Bhavesh6/PPE-Detection/frontend/assets/checkpoint-granted.png

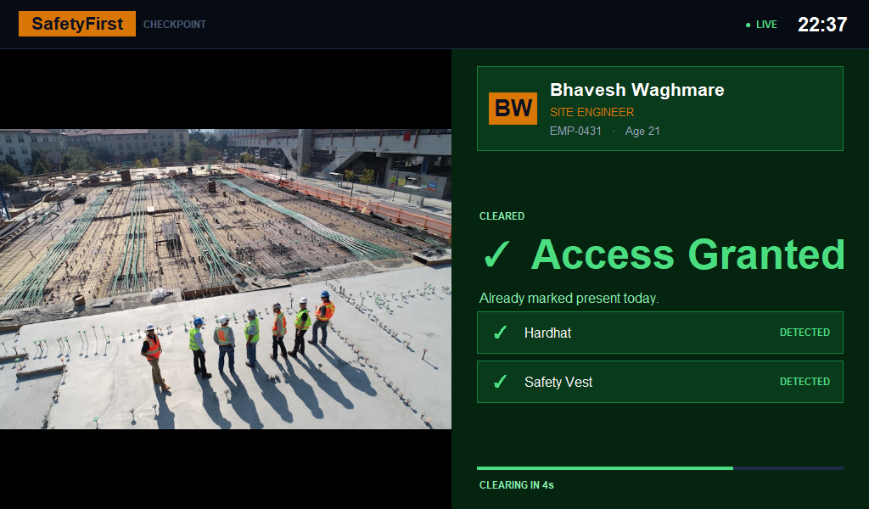
frontend/assets/checkpoint-granted.png
