Bhavesh6/PPE-Detection/frontend/assets/checkpoint-denied.png

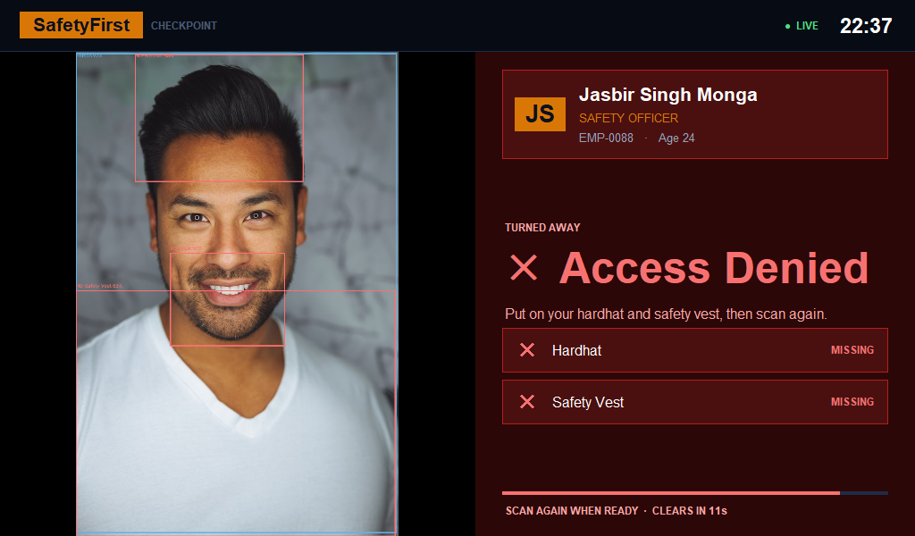
frontend/assets/checkpoint-denied.png
