Bhavesh6/PPE-Detection/frontend/assets/checkpoint-idle.png

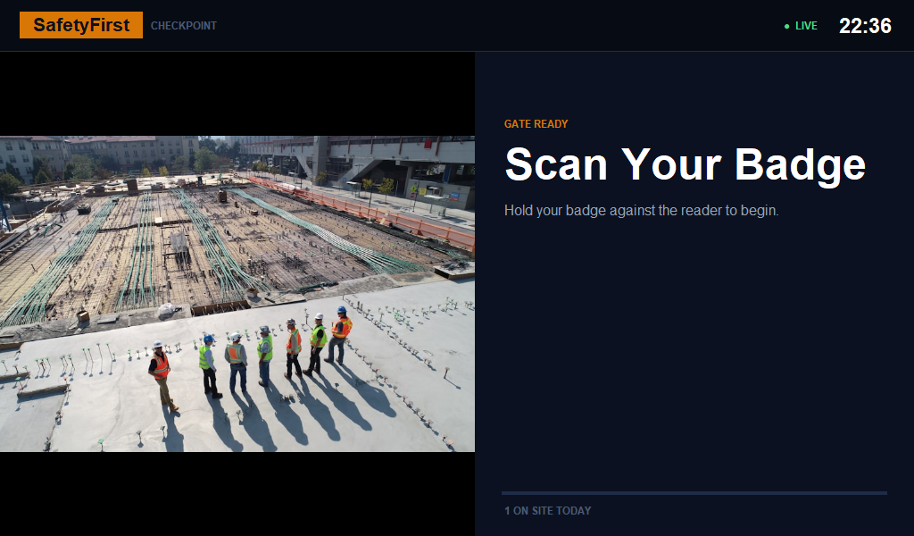
frontend/assets/checkpoint-idle.png
