Bhavesh6/PPE-Detection/pi_app/doctor.py

"""Pre-flight check for the checkpoint device.

Run this on the Pi before trusting the gate - it walks the chain from
kernel to badge to backend and says which link is broken, rather than
leaving you to infer it from a blank screen at demo time.

    python doctor.py            # everything except the card read
    python doctor.py --scan     # also waits for a badge to be presented
"""

from __future__ import annotations

import glob
import os
import sys
from pathlib import Path

# Read the same .env checkpoint.py reads, before anything below looks at
# os.environ. Without this the doctor diagnoses a configuration nobody
# runs: it would miss SAFETYFIRST_GPS=off and pass a GPS the gate has
# switched off, check localhost instead of the real SAFETYFIRST_API, and
# warn about missing device credentials that are sitting in the file. A
# pre-flight check that reads different settings than the app is worse
# than none, because it is believed.
try:
    from dotenv import load_dotenv

    load_dotenv(Path(__file__).with_name(".env"))
except ImportError:
    pass

OK, BAD, WARN = "  OK  ", " FAIL ", " WARN "
_failures = 0
_warnings = 0


def report(status, title, detail=""):
    global _failures, _warnings
    if status is BAD:
        _failures += 1
    elif status is WARN:
        _warnings += 1
    print(f"[{status}] {title}")
    if detail:
        for line in str(detail).splitlines():
            print(f"         {line}")


def check_platform():
    model = "unknown"
    try:
        with open("/proc/device-tree/model") as f:
            model = f.read().strip("\x00").strip()
    except OSError:
        pass

    if "Raspberry Pi" in model:
        report(OK, "Hardware", model)
    else:
        report(WARN, "Hardware", f"Not a Raspberry Pi ({model}).\n"
                                 "SPI and GPIO checks below will fail; that's expected off-device.")


def check_spi():
    devices = sorted(glob.glob("/dev/spidev*"))
    if devices:
        report(OK, "SPI enabled", ", ".join(devices))
        return True
    report(BAD, "SPI enabled",
           "No /dev/spidev* device.\n"
           "Enable it: sudo raspi-config -> Interface Options -> SPI -> Yes, then reboot.")
    return False


def check_libraries():
    missing = []
    for module, package in (("spidev", "spidev"),
                            ("RPi.GPIO", "RPi.GPIO"),
                            ("mfrc522", "mfrc522")):
        try:
            __import__(module)
        except ImportError:
            missing.append(package)

    if missing:
        # Not a failure any more. Badges reach this Pi from the sensor mesh
        # through the master ESP32 over USB; the RC522 on the SPI header is
        # the fallback for a gate with no master attached. Reporting FAIL
        # here painted a fully working checkpoint red, which is worse than
        # saying nothing — a red line nobody can act on teaches people to
        # ignore the whole report. check_reader() below tests what is
        # actually being used.
        report(WARN, "Reader libraries",
               f"Not installed: {', '.join(missing)}\n"
               "Only needed for a direct RC522 on the SPI header. If the gate\n"
               "master ESP32 is attached over USB, this is expected and fine.\n"
               f"To add the fallback anyway: pip install {' '.join(missing)}")
        return False
    report(OK, "Reader libraries", "spidev, RPi.GPIO, mfrc522")
    return True


def check_camera():
    try:
        import cv2
    except ImportError:
        report(BAD, "Camera", "opencv is not installed (pip install opencv-python-headless)")
        return

    setting = os.environ.get("SAFETYFIRST_CAMERA") or "0"

    # Resolve exactly the way the gate does. SAFETYFIRST_CAMERA accepts a
    # name fragment ("HD camera") as well as an index, and int()-ing it here
    # killed the doctor on a setting the gate handles perfectly well — the
    # pre-flight check crashing on a working configuration.
    try:
        from checkpoint import _camera_candidates

        candidates = _camera_candidates()
    except Exception:  # noqa: BLE001 - checkpoint pulls in the whole GUI stack
        parts = [p.strip() for p in setting.split(",") if p.strip()]
        candidates = [int(p) for p in parts] if all(p.isdigit() for p in parts) else [0]

    for index in candidates:
        cap = cv2.VideoCapture(index)
        try:
            if not cap.isOpened():
                continue
            ok, frame = cap.read()
            if not ok or frame is None:
                continue
            h, w = frame.shape[:2]
            report(OK, "Camera", f"{setting!r} -> index {index}, {w}x{h}")
            return
        finally:
            cap.release()

    report(BAD, "Camera",
           f"No working camera for SAFETYFIRST_CAMERA={setting!r}.\n"
           f"Tried index(es): {', '.join(str(c) for c in candidates)}\n"
           "Check the connection, or set SAFETYFIRST_CAMERA to an index or a\n"
           "name fragment from: v4l2-ctl --list-devices")


def check_backend():
    try:
        import requests
    except ImportError:
        report(BAD, "Backend", "requests is not installed (pip install requests)")
        return None

    base = os.environ.get("SAFETYFIRST_API", "http://localhost:5000")
    try:
        res = requests.get(f"{base}/api/health", timeout=5)
    except Exception as exc:  # noqa: BLE001
        report(BAD, "Backend reachable",
               f"{base} did not respond ({exc.__class__.__name__}).\n"
               "Start it, or point SAFETYFIRST_API at the machine running it.")
        return None

    if res.status_code != 200:
        report(BAD, "Backend reachable", f"{base} returned HTTP {res.status_code}")
        return None

    report(OK, "Backend reachable", base)
    return base


def check_credentials(base):
    if not base:
        return None
    import requests

    email = os.environ.get("SAFETYFIRST_EMAIL", "")
    password = os.environ.get("SAFETYFIRST_PASSWORD", "")
    if not email or not password:
        report(WARN, "Device credentials",
               "SAFETYFIRST_EMAIL / SAFETYFIRST_PASSWORD are unset.\n"
               "The gate signs in as a guest, which cannot record attendance.")
        return None

    try:
        res = requests.post(f"{base}/api/auth/login",
                            json={"email": email, "password": password}, timeout=5)
        data = res.json()
    except Exception as exc:  # noqa: BLE001
        report(BAD, "Device credentials", f"Sign-in failed ({exc})")
        return None

    if res.status_code != 200 or not data.get("success"):
        report(BAD, "Device credentials", data.get("message", "Sign-in rejected"))
        return None

    report(OK, "Device credentials", f"signed in as {email}")
    return data["token"]


def check_policy(base, token):
    if not base or not token:
        return
    import requests

    try:
        res = requests.get(f"{base}/api/status",
                           headers={"Authorization": f"Bearer {token}"}, timeout=5)
        required = res.json().get("required_ppe", [])
    except Exception as exc:  # noqa: BLE001
        report(WARN, "Site policy", f"Could not read it ({exc})")
        return

    if required:
        report(OK, "Site policy", "requires " + ", ".join(required))
    else:
        report(WARN, "Site policy", "No equipment is required - the gate will admit everyone.")


def check_reader(scan):
    try:
        import badge_reader
    except ImportError as exc:
        report(BAD, "Badge reader", str(exc))
        return

    try:
        reader = badge_reader.open_reader()
    except SystemExit as exc:
        report(BAD, "Badge reader", str(exc))
        return

    if isinstance(reader, badge_reader.KeyboardReader):
        report(WARN, "Badge reader",
               "Falling back to keyboard input - the RC522 was not detected.\n"
               "Check wiring: SDA->GPIO8, SCK->GPIO11, MOSI->GPIO10, MISO->GPIO9, RST->GPIO25, 3.3V (not 5V).")
        return

    report(OK, "Badge reader", reader.name)

    if not scan:
        print("         (run with --scan to test an actual card)")
        return

    import time
    print("\n         Present a badge to the reader (20s)...")
    reader.start()
    deadline = time.time() + 20
    tag = None
    while time.time() < deadline and tag is None:
        tag = reader.read()
        time.sleep(0.1)
    reader.stop()

    if tag:
        report(OK, "Badge scan", f"read tag {tag}")
        print("         Register it: set this as the worker's rfid_tag in the console.")
    else:
        report(BAD, "Badge scan", "No card seen in 20s. Check wiring and that the card is 13.56MHz (MIFARE).")


def check_gps(scan):
    try:
        import gps_reporter
    except ImportError as exc:
        report(BAD, "GPS", str(exc))
        return

    preference = (os.environ.get("SAFETYFIRST_GPS") or "auto").strip().lower()
    if preference == "off":
        report(WARN, "GPS",
               "SAFETYFIRST_GPS is off - location stays whatever the console\n"
               "has set. Unset it to go back to auto, which finds the module\n"
               "by USB vendor id when one is plugged in and stays quiet when\n"
               "one is not.")
        return

    try:
        reader = gps_reporter.open_gps()
    except SystemExit as exc:
        report(BAD, "GPS", str(exc))
        return

    if isinstance(reader, gps_reporter.NullGPSReader):
        # Say which of the two failures this is. "Nothing plugged in" and
        # "plugged in but talking to the wrong interface" need opposite
        # fixes, and a single message covering both sends people to
        # re-check cabling that was never the problem.
        found = gps_reporter._quectel_ports()
        if found:
            detail = ("A Quectel modem is present but no interface answered AT:\n  "
                      + "\n  ".join(found)
                      + "\nCheck it is powered (STATUS LED on) and pyserial is installed.")
        else:
            port = os.environ.get("SAFETYFIRST_GPS_PORT")
            detail = ("No Quectel modem on the USB bus"
                      + (f", and {port} did not open" if port else
                         ", and no SAFETYFIRST_GPS_PORT is set")
                      + ".\nFor the TracX-1b: connect it over USB-C with the jumper on the\n"
                        "USB pads. For a plain NMEA module: set SAFETYFIRST_GPS_PORT and\n"
                        "install pyserial + pynmea2.")
        report(WARN, "GPS", detail)
        return

    report(OK, "GPS", reader.name)

    if not scan:
        print("         (run with --scan to wait for an actual fix)")
        return

    import time
    print("\n         Waiting for a GPS fix (30s) - this can take a while outdoors on cold start...")
    reader.start()
    deadline = time.time() + 30
    fix = None
    while time.time() < deadline and fix is None:
        fix = reader.latest()
        time.sleep(0.5)
    reader.stop()

    if fix:
        report(OK, "GPS fix", f"{fix[0]:.6f}, {fix[1]:.6f}")
    else:
        report(BAD, "GPS fix", "No fix in 30s. Needs clear sky view; cold start can take a couple of minutes.")


def check_offline_queue():
    try:
        import offline_queue
    except ImportError as exc:
        report(BAD, "Offline queue", str(exc))
        return

    try:
        backlog = offline_queue.OfflineQueue().count()
    except Exception as exc:  # noqa: BLE001
        report(BAD, "Offline queue", f"Could not open {offline_queue.DB_PATH} ({exc})")
        return

    if backlog:
        report(WARN, "Offline queue",
               f"{backlog} attendance record(s) still waiting to sync.\n"
               "Normal right after an outage - the gate retries automatically while\n"
               "running. Worth investigating if this stays non-zero for a while.")
    else:
        report(OK, "Offline queue", "empty")


def main():
    scan = "--scan" in sys.argv
    print("\nSafetyFirst checkpoint pre-flight\n" + "=" * 40)

    check_platform()
    check_spi()
    check_libraries()
    check_camera()
    base = check_backend()
    token = check_credentials(base)
    check_policy(base, token)

    # Always run. open_reader() prefers the master ESP32 over USB and only
    # falls back to an RC522 on the SPI header, so gating this on the SPI
    # libraries skipped the check on exactly the gates that use the
    # supported path: the badge wire, the one thing a checkpoint cannot do
    # without, went untested on every Pi wired the way this ships. The
    # check reports whichever reader it actually got.
    check_reader(scan)

    check_gps(scan)
    check_offline_queue()

    print("=" * 40)
    if _failures:
        print(f"{_failures} problem(s) must be fixed before the gate is usable.")
    elif _warnings:
        print(f"Usable, with {_warnings} warning(s) above.")
    else:
        print("All checks passed - the checkpoint is ready.")
    return 1 if _failures else 0


if __name__ == "__main__":
    sys.exit(main())
