Bhavesh6/PPE-Detection/pi_app/serial_bridge.py

"""The master ESP32, over USB.

Sensor nodes talk ESP-NOW to a master board; the master is wired to the Pi by
USB and forwards everything down one serial line. That covers two kinds of
traffic which used to arrive separately — badge scans (previously an RC522 on
the Pi's own SPI header) and hazard reports (previously an HTTP POST) — so
this is a `BadgeReader` that also feeds the local alert store, rather than
two objects fighting over one port. Only one process can hold a serial
device open, so they could not be split even if it were tidier.

Line protocol, one message per line, verb first. Case-insensitive, and any
line that doesn't parse is ignored rather than logged — an ESP32 prints a
burst of bootloader noise at every reset, and treating that as an error
would fill the log each time the board is power-cycled:

    BADGE 0006238412
    ALERT gas critical fumes near the mixer
    READING gas 450 ppm

`READING` carries a raw value and is classified against the site thresholds
the roster sync caches, exactly as the HTTP receiver does — the same ppm has
to mean the same thing whichever way it reached the Pi.

The port is reopened if it disappears, so unplugging the master and plugging
it back in recovers on its own, matching how the camera behaves.
"""

from __future__ import annotations

import os
import time

import usb_devices
from badge_reader import BadgeReader

BAUD = int(os.environ.get("SAFETYFIRST_SERIAL_BAUD", "115200"))
RECONNECT_SECONDS = 3.0
# Same reasoning as the RC522 path: dedupe on time, not identity, so a worker
# turned away can fix their gear and re-present the same badge.
REPEAT_LOCKOUT_SECONDS = 3.0

# How often this Pi tells the master its temperature. Comfortably inside
# the master's 30s failsafe, so a single missed update never spins the
# fan up on its own — only a genuinely silent Pi does.
TEMP_REPORT_SECONDS = float(os.environ.get("SAFETYFIRST_TEMP_REPORT_INTERVAL", "5"))


# Who this module is, as far as the port registry is concerned. Claiming
# under a name is what keeps the GPS reader out of the badge wire.
OWNER = "gate"


def find_port() -> str | None:
    """The master board's port, or None.

    Identified rather than guessed - see usb_devices. This used to take
    the first /dev/ttyUSB*, which on a checkpoint with the GNSS modem
    attached is one of the modem's seven interfaces and not the gate at
    all: badges stopped arriving the moment location was plugged in.
    """
    return usb_devices.find_gate_master(owner=OWNER)


class SerialBridgeReader(BadgeReader):
    """Badge scans and hazard reports arriving from the master over USB."""

    name = "ESP32 master (USB serial)"

    def __init__(self, port: str | None = None, alerts=None, policy_provider=None,
                 readings=None):
        super().__init__()
        import serial  # late: only needed when a board is actually attached

        self._serial = serial
        self._port = port or os.environ.get("SAFETYFIRST_SERIAL_PORT") or ""
        self._alerts = alerts
        self._policy = policy_provider or (lambda: {})
        self._readings = readings
        self._conn = None
        # The path currently held, so _close releases exactly what _open
        # claimed even after auto-detection moved to a different port.
        self._active: str | None = None

        # Last fan status the master reported. Read by doctor.py and the
        # gate's status line; None-ish values mean it has never spoken,
        # which is different from a fan reporting zero.
        self.fan_duty: int | None = None
        self.fan_rpm: int | None = None
        self.fan_seen_at: float = 0.0

    # -- connection ------------------------------------------------------
    def _open(self) -> bool:
        port = self._port or find_port()
        if not port:
            return False
        # Two readers, one process: whoever claims the path owns it until
        # they close it.
        if not usb_devices.claim(port, OWNER):
            return False
        try:
            # A read timeout rather than blocking, so stop() can end this
            # thread instead of it sitting in readline() forever.
            self._conn = self._serial.Serial(port, BAUD, timeout=1)
            # Throw away whatever accumulated while nothing was reading.
            # Measured on the bench: opening the port delivered 95 copies
            # of one reading in a single second - the same value, filed 95
            # times with the timestamp of the moment we opened, which is a
            # spike in the history that never happened. Steady state is a
            # clean line every couple of seconds; only this backlog is
            # wrong, and it is stale by definition.
            self._conn.reset_input_buffer()
            self._active = port
            self.name = f"ESP32 master ({port})"
            return True
        except (OSError, self._serial.SerialException):
            usb_devices.release(port, OWNER)
            # The remembered board did not open. It may have been
            # unplugged and something else may now hold that path, so the
            # next attempt starts from a fresh probe rather than trusting
            # the cache back onto the wrong device.
            usb_devices.forget_master()
            self._conn = None
            return False

    def _close(self) -> None:
        if self._conn is not None:
            try:
                self._conn.close()
            except Exception:  # noqa: BLE001 - already going away
                pass
            self._conn = None
        usb_devices.release(self._active, OWNER)
        self._active = None

    # -- protocol --------------------------------------------------------
    def _handle(self, line: str, last: dict) -> None:
        parts = line.split()
        if len(parts) < 2:
            return
        verb = parts[0].upper()

        if verb == "BADGE":
            tag = parts[1].strip()
            now = time.monotonic()
            if not tag:
                return
            if tag != last.get("tag") or now - last.get("at", 0.0) >= REPEAT_LOCKOUT_SECONDS:
                last["tag"] = tag
                last["at"] = now
                self.tags.put(tag)
            return

        if verb == "FAN" and len(parts) >= 3:
            # Status, not an alert — handled before the _alerts guard
            # below so the fan still reports on a gate started without
            # the local alert receiver.
            try:
                self.fan_duty = int(parts[1])
                self.fan_rpm = int(parts[2])
            except ValueError:
                return
            self.fan_seen_at = time.monotonic()
            # A fan reporting 0 RPM while being driven is a seized or
            # unplugged fan, and the Pi behind it is about to get hot.
            # Worth a line; the duty alone would look perfectly healthy.
            if self.fan_duty > 0 and self.fan_rpm == 0:
                print(f"[serial] fan at {self.fan_duty}% but reporting 0 RPM — check it is spinning")
            return

        if self._alerts is None:
            return

        if verb == "ALERT" and len(parts) >= 3:
            kind, severity = parts[1], parts[2].lower()
            if severity not in ("critical", "warning", "info"):
                return
            message = " ".join(parts[3:])
            self._alerts.record(kind, severity, message, source="esp32-master")
            print(f"[serial] {severity} {kind} alert from the master")
            return

        if verb == "READING" and len(parts) >= 3:
            from local_alerts import evaluate

            kind = parts[1]
            try:
                value = float(parts[2])
            except ValueError:
                return
            unit = parts[3] if len(parts) > 3 else ""

            # Buffer every reading, crossing or not. Online the backend logs
            # them all; offline they used to vanish, leaving holes in the
            # history exactly where the network was worst — so a trend that
            # was climbing towards a threshold looked like it started the
            # moment the connection came back.
            if self._readings is not None:
                self._readings.record(kind, value, unit, source="esp32-master")

            thresholds = (self._policy() or {}).get("sensor_thresholds") or {}
            severity, _cfg = evaluate(kind, value, thresholds)
            if severity is None:
                return          # below threshold, or none configured
            self._alerts.record(kind, severity, f"{kind} reading {value}{unit}",
                                source="esp32-master", value=value)
            print(f"[serial] {kind} {value}{unit} crossed {severity}")

    # -- cooling ----------------------------------------------------------
    def _cpu_temperature(self) -> float | None:
        """This Pi's CPU temperature in °C, or None if it can't be read.

        Read from sysfs rather than `vcgencmd`. vcgencmd is installed on
        this Pi but cannot be used by the gate: it talks to /dev/vcio,
        which is root:video 0660, and this process is not in that group —
        it exits 255 with "Can't open device file". sysfs needs no
        privileges and no group membership at all.
        """
        try:
            with open("/sys/class/thermal/thermal_zone0/temp") as handle:
                return int(handle.read().strip()) / 1000.0
        except (OSError, ValueError):
            return None

    def _send_temperature(self) -> None:
        """Tell the master how hot we are, so it can set the fan.

        The AI HAT has no temperature sensor and the Pi's fan header is
        occupied, so the master drives the fan — but only this side knows
        the temperature. Load goes with it as a leading indicator: a Pi
        that has just started inference is already making the heat its
        sensor will report twenty seconds from now.

        Failure here is deliberately quiet. The master treats silence as
        a fault and speeds the fan up on its own, so a Pi that cannot
        report is cooled harder rather than not at all.
        """
        temp = self._cpu_temperature()
        if temp is None or self._conn is None:
            return
        try:
            load = os.getloadavg()[0]
        except OSError:
            load = 0.0
        try:
            self._conn.write(f"TEMP {temp:.1f} {load:.2f}\n".encode("ascii"))
        except Exception:  # noqa: BLE001 - a write failure is the reader's problem
            pass

    # -- loop ------------------------------------------------------------
    def _loop(self) -> None:
        last: dict = {}
        next_temp = 0.0
        while self._running:
            if self._conn is None:
                if not self._open():
                    time.sleep(RECONNECT_SECONDS)
                    continue

            # readline() below has a 1s timeout, so this loop is already
            # a usable clock — no separate thread needed for the update.
            now = time.monotonic()
            if now >= next_temp:
                next_temp = now + TEMP_REPORT_SECONDS
                self._send_temperature()

            try:
                raw = self._conn.readline()
            except Exception:  # noqa: BLE001
                # Deliberately broad. Two different things land here: the
                # master being unplugged mid-read, and stop() closing the
                # port underneath this thread at shutdown. Neither may kill
                # the loop — a dead reader thread means badges silently stop
                # being read, with nothing on screen to say why.
                if not self._running:
                    break
                self._close()
                print("[serial] master disconnected — waiting for it")
                time.sleep(RECONNECT_SECONDS)
                continue

            if not raw:
                continue        # idle timeout, not an error

            try:
                line = raw.decode("utf-8", errors="replace").strip()
            except Exception:  # noqa: BLE001
                continue
            if line:
                self._handle(line, last)

    def stop(self) -> None:
        super().stop()
        self._close()
