Bhavesh6/PPE-Detection/(commit log)

2026-08-02 Install UI/UX design skills for round 2 polish
    Project-level Claude Code skills so frontend/design work in this repo
    follows better UI/UX practice going forward:
    - ui-ux-pro-max, ui-styling, design, design-system, brand, banner-design,
    slides (from nextlevelbuilder/ui-ux-pro-max-skill)
    - impeccable + its dedicated agents (from pbakaus/impeccable) - the
    design-critique/polish skill itself, invocable manually
    - figma-implement-design (from openai/skills .curated) - implementing
    Figma mockups as code
    Deliberately NOT included: impeccable's .claude/settings.json, which
    wires PostToolUse/Stop hooks to auto-run a Node script on every
    Edit/Write/MultiEdit to a UI file and again when a sessi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
2026-08-02 Guard AOS.init() so a blocked/failed CDN script doesn't kill the page
    Ran the full app end-to-end (real Flask backend, real best.pt YOLO
    inference, Playwright with a fake camera device) to verify round 2
    before polishing anything further. Signup, login, per-user detection
    state, live counts, and the auth guard on visit-site.html all worked
    correctly against real requests.
    Found one real bug in the process: visit-site.html and index.html
    called AOS.init() unconditionally at the top of their main inline
    script block. If the AOS script fails to load (CDN down, blocked,
    ad-blocker, offline), that throws ReferenceError and silently kills
    every statement after it in the same block - on visit-site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
2026-08-03 Turn the detector into an access-control checkpoint
    The app counted PPE but never decided anything. It now rules on entry,
    keeps the ruling, and presents it to the three people who need it.
    Gate decision
    - evaluate_access() checks the frame against required PPE (Hardhat,
    Safety Vest) and returns granted / denied / no_person plus exactly
    what is missing.
    - Decisions are events, not frames: a verdict is counted and persisted
    only when it changes. Standing at the checkpoint previously wrote a
    DB row every frame (~120/min), burying real entries under duplicates.
    - Removed the Gloves counter throughout. The trained model has no such
    class, so it could only ever read zero.
    Record
    - Det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
2026-08-05 Add RFID badge identification and attendance to the gate
    The checkpoint could decide whether someone was wearing the right gear,
    but not who they were. A badge scan now resolves a worker profile, and
    the resulting entry or refusal is recorded as attendance.
    Attendance is kept separate from DetectionRecord on purpose: that table
    logs what the camera saw, this one logs that a named person presented
    themselves and whether they got in. Attendance is the record a
    supervisor is asked for; detections are the evidence behind it.
    pi_app/ is the native checkpoint client for the gate-mounted Pi —
    Tkinter rather than a browser so it survives without a window manager,
    with an MFRC522 SPI reader and a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
    [badge_reader.py, checkpoint.py, ui.py]
2026-08-05 Rebuild the interface around one light, editorial design language
    The console and the public site had drifted into two different products —
    a dark navy dashboard behind a marketing page that shared none of its
    vocabulary. Everything now speaks the same language: warm paper, burnt
    clay, Fraunces over Inter.
    Light rather than dark was a deliberate call. Depth on an all-light page
    has to come from real elevation, overlap and imagery, since removing
    shadows without the hard black-on-white contrast that usually justifies
    that rule just leaves a stack of paper cut-outs.
    Also scopes navigation by role, so a guest is offered the demo rather
    than the empty pages a guest can never fill, and the de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
2026-08-05 Add analytics, CSV export, and a worker's own profile
    A count of violations says there is a problem; which requirement fails
    and when it fails says what to change. Analytics answers the second
    question — what is missing most, when refusals cluster, how compliance
    moves, and which workers need attention.
    Overview and Analytics were showing the same figures under different
    names, and worse, over different windows: all-time versus a rolling 30
    days. They agreed only because the data was young. Overview now covers
    today and Analytics covers time, so the two can no longer disagree.
    Verdict filtering moved server-side, since filtering one already-paginated
    page while the pager counted the unfi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
2026-08-05 Make checkpoint policy configurable instead of hardcoded
    What the gate demands was two constants: REQUIRED_PPE and a confidence
    threshold buried in the model call. But that's a site decision, not a
    code decision — a scaffolding job and a welding bay don't require the
    same gear, and changing either meant a redeploy.
    An administrator now sets both from the console, and the next frame
    honours it. Verified against live inference: the same photograph is
    granted under hardhat+vest, denied when a mask is added to the policy,
    and granted again under hardhat alone.
    The settings cache is deliberate. /api/socket consults the policy on
    every frame, so a database round-trip there would cost more than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
2026-08-05 Render requirement lists from policy instead of hardcoding them
    Changing the required PPE changed what the gate decided, but every
    surface that displayed the requirements still listed Hardhat and Safety
    Vest from markup. Selecting Hardhat alone still showed both, and Mask
    could never appear at all — the rows, their element ids, and the
    missing-item checks were all written out by hand.
    Gate Control, the kiosk display and the Pi checkpoint now build their
    rows from the site policy and rebuild when it changes, so a gate can no
    longer advertise equipment it doesn't check. /api/socket reports the
    policy alongside each verdict, since the device reads that endpoint
    rather than /api/status.
    Veri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
    [checkpoint.py]
2026-08-05 Filter the camera overlay and log to the site's actual policy
    Setting the policy to hardhat alone still painted red NO-Mask and
    NO-Safety Vest boxes over the worker, and filled the detection feed with
    them. The model reports every class it knows; drawing all of them tells
    someone they've failed a check this site doesn't run.
    Gate Control, the kiosk and the Pi device now show people always, and
    equipment only where the policy requires it. Where the policy is not yet
    known nothing is filtered, so a slow first poll can't blank the overlay.
    [checkpoint.py]
2026-08-05 Keep the frame behind every refusal
    A log line saying "Hardhat missing" asks a supervisor to take the
    system's word for it, and gives a worker nothing to argue with. Refusals
    now store the frame that produced them, with the model's own boxes and a
    timestamp burned in, so the record stands on its own months later.
    Only refusals are photographed. Grants have nothing to answer for, and
    photographing everyone who passes turns a safety gate into surveillance.
    Images expire after 30 days while the decision is kept permanently — the
    system shouldn't quietly accumulate a photographic record of every
    worker's bad day.
    Each record also stores the policy in force at the time. Without it a
    trend spa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
2026-08-05 Fix badge re-scanning, and add a device pre-flight check
    The RC522 reader has never run on hardware, and reviewing it before it
    does turned up a bug that would have surfaced immediately: it deduped
    purely on "different from the last tag", with a reset branch that only
    ran on an empty read. But read() blocks until a card is present and never
    returns empty, so that branch was unreachable — meaning the same badge
    could never be scanned twice in a row. A worker turned away for a missing
    hardhat, who then puts one on and re-presents the same card, would have
    been met with silence.
    Deduping is now on time as well as identity, using the non-blocking read:
    holding a card still counts once, but th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
    [badge_reader.py, doctor.py]
2026-08-05 Add report presets, operator snapshots, and personnel filtering
    Three things from the design review, all reading data that already exists.
    Reports replaces the single export-everything CSV with three named
    reports over a chosen period: gate activity, refusals, and per-worker
    compliance. The `to` date is inclusive of its whole day, since a
    supervisor asking for the 5th to the 5th means that day, not the instant
    it began.
    Snapshot lets an operator store the current frame on demand. The gate
    photographs refusals by itself, but not everything worth recording is
    something the policy covers — an unsafe act, damaged gear, someone who
    talked their way through. Snapshots are a distinct verdict so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
2026-08-06 Show model inference speed on the live view
    Last item from the design review that doesn't need hardware. The gate
    measures how long each inference takes and reports frames per second
    alongside the camera, colour-graded: below about five frames a second a
    person can walk through between checks, which is worth knowing before it
    matters.
    Timed around the model call alone, not decode or transport, so the figure
    means one thing. It's also the number that should visibly change when the
    AI HAT takes over from the CPU, which makes it the cheapest proof that
    on-device inference is actually working.
    The first inference of a session is discarded. It carries one-off setup
    and measured 11,800ms here ag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
2026-08-06 Record who changes how the gate behaves
    Making the checkpoint policy configurable left a hole: an administrator
    could drop the required equipment to nothing, walk people through, and
    set it back, and no record anywhere would show it. Every compliance
    figure downstream was unfalsifiable.
    Policy changes and personnel deletions are now recorded with the actor,
    the time, and what actually moved — "stopped requiring Safety Vest;
    confidence 0.25 to 0.5" rather than a diff of everything. Changes that
    weaken the gate are marked, since those are the ones worth finding in a
    long list.
    The actor's name is stored alongside the id so the trail still reads
    after an account is deleted. There is no endp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
2026-08-06 Fix bugs found by a live full-site audit
    Requested a full pass across every page, driven live rather than read as
    source. Found and fixed:
    - violations.html: worker name and employee ID/role ran together on one
    line. Same shape as three earlier fixes this session (settings.html,
    reports.html, pi-home.html) — a plain inline span with no display:block,
    inside a non-flex parent that never blockifies it — missed here because
    this page was built after those fixes landed. Confirmed via
    getBoundingClientRect() at normal desktop width before fixing.
    - login.html: both submit buttons permanently changed casing after their
    first use ("Sign in" to "Sign In", "Create account" to "Creat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
2026-08-07 Update the homepage to describe what actually got built
    The page was still describing the product from before this session:
    three thin surface cards and a roadmap that listed "permanent compliance
    record" as the whole of "working today." Since then the console gained
    evidence photography, a configurable checkpoint policy, an audit trail,
    analytics, and named reports — none of it mentioned anywhere a visitor
    would see it.
    The Admin Console card now lists what's actually there. The roadmap's
    "working today" column reflects the real feature set, and "next" replaces
    stale placeholder items with what's actually planned — RFID and the Pi
    app on real hardware, then GPS. The "It tells them what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
2026-08-07 Add live site-location tracking and fix a sidebar overflow bug
    Site location is now source-tracked (manual vs device) and timestamped
    server-side, with a new device-facing /api/gate/location endpoint so a
    GPS module can report fixes without needing an admin account. The admin
    console's Site Location page polls for fresh fixes and shows a live/stale
    badge instead of treating the point as permanently fixed.
    pi_app gets a gps_reporter.py mirroring badge_reader.py's shape (serial
    NMEA reader + no-op fallback, off by default) and a doctor.py pre-flight
    check for it, so wiring up real hardware later needs no code changes.
    Also fixes .sidebar-nav and kiosk.html's .k-verdict overflowing their
    cont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
    [checkpoint.py, doctor.py, gps_reporter.py]
2026-08-07 Rewrite README as the current-state map of the project
    The old README described round-1's architecture (webcam dashboard +
    auth only) and was silent on everything built since: the admin console,
    the RFID gate, configurable policy, evidence capture, audit log, GPS,
    and the Pi app's hardware readiness. Rewritten as a single map covering
    what's working, what's designed but unbuilt, what's untested on real
    hardware, and why certain things (cloud vs local inference, no
    gloves/boots detection) were deliberately deferred — so picking this up
    on a different machine, or handing it to a teammate, doesn't require
    re-deriving any of that from code or memory.
    pi_app/README.md also had gone stale in a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
2026-08-07 Add sensor alerts: a critical hazard holds the gate, everywhere
    New SensorAlert model + alerts.py (cached "is a critical alert active"
    check, mirroring how site_settings caches the checkpoint policy since
    evaluate_access() now checks this on every frame). A critical alert
    overrides PPE compliance entirely via a new alert_hold verdict — someone
    in full gear still isn't safe to admit into a gas leak — kept out of
    DetectionRecord persistence since it isn't a ruling on the person in
    frame, and out of the audit log's routine noise since the SensorAlert
    row itself is the record of who cleared it and when.
    Endpoints: POST /api/gate/alerts (device-facing — used by the admin
    console's "simulat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
    [checkpoint.py, ui.py]
2026-08-07 Fix icon/timestamp misalignment on wrapped alert messages, add headcount to Alerts page
    Both the global alert popup banner and the Alerts page's "Active now"
    list laid out icon + message + timestamp + button as one align-items:center
    flex row. A short alert message stayed one line and looked fine; a longer
    one wrapped to several lines, and centering the short siblings against
    that whole tall block floated the icon and timestamp in the vertical
    middle of the paragraph instead of level with its first line — readable,
    but visibly misaligned once a real message showed up. Restructured both
    into two rows (icon+message on top, timestamp+button below) so the icon
    always sits with the first line r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
2026-08-07 Add an ESP32 connectivity test sketch, ahead of the Pi or sensor hardware
    The ESP32 arrived before the Raspberry Pi (still with a friend), so there
    was no way yet to test whether it can even reach this backend over the
    network. esp32-sim/alert_sim.ino answers exactly that: it signs in the
    same way pi_app/checkpoint.py's ApiClient does, then reports a simulated
    alert to the real /api/gate/alerts endpoint on a Serial Monitor command
    (gas/smoke/warn). If it shows up in the admin console, the network path
    and auth flow both work — the two things this was actually testing.
    Cross-checked the request/response shapes directly against auth.py and
    gate.py rather than guessing: /api/auth/guest retur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
2026-08-07 Add threshold-based sensor alerts, so a device can report a number instead of deciding severity
    A device declaring its own severity ("critical") only gets you so far —
    real sensors report numbers, and what counts as a problem is a site
    decision, not something to hardcode into firmware. New SensorReading
    model holds the latest value per kind (not a history — just "what does
    this sensor say right now"); site_settings gains a sensor_thresholds key
    (per kind: warning_at/critical_at/unit/direction), reusing the existing
    /api/admin/settings GET/PUT rather than adding new admin endpoints.
    alerts.report_reading() classifies a raw value against its configured
    threshold and, on a breach, calls th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
    [alert_sim.ino]
2026-08-10 Polish the homepage: remove kicker labels, fix a real mobile layout bug
    Removed all 8 "eyebrow" labels (HOW IT WORKS, WHY IT MATTERS, etc.) sitting
    above section headings — the heading already carries the section's topic;
    the label above it was pure repetition.
    Redesigned the pull-quote: swapped the colored border-left rule for an
    oversized Fraunces opening-quote glyph, so "this is a quote" reads as a
    typographic choice instead of a bordered callout box.
    Real bug found and fixed along the way: .hero-grid (the top hero's
    image+text layout) was missing from the mobile breakpoint that collapses
    every other two-column section to one — it stayed two-column under 820px,
    squeezing the hero ph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
2026-08-10 Add a round-one-to-round-two report to the homepage, for judging
    The homepage described what the product does but never accounted for what
    this round actually delivered. New #report section, linked from the header
    and footer, written as a document rather than more marketing: ruled rows
    and a label column instead of the card grids the rest of the page uses.
    The spine of it is round one's own closing slide. That deck promised edge
    deployment on a Pi, RFID tags, automated gate control at checkpoints, and
    IoT sensors with an offline mode — so the report marks that list against
    what is actually running, in three honest states rather than a tick and a
    cross. Four are built, one is partly there,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
2026-08-10 Report only completed work, and tighten the page's vertical rhythm
    Two changes to the homepage report, both requested.
    Scope: the report no longer carries a "what is not done" list, and the
    promises table now shows only what round two delivered — five items, so
    the status column went with it since every row said the same thing. The
    face-recognition entry was not a gap but a deliberate choice, so its
    argument moved into the decisions block as "Identity comes from a badge,
    not a face" rather than being dropped. Nothing left on the page claims
    hardware that has not been tested: the roadmap section below still lists
    the Pi, the relay, the AI HAT and GPS as what comes next.
    Length: the page w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
2026-08-11 Document the real ElevenLabs gotcha found while wiring up a live key
    Verified end-to-end against a real account: the 402 "Free users cannot
    use library voices via the API" isn't a plan limitation, it's specific to
    voices that have only been viewed in the Voice Library. A voice explicitly
    added to the account (Voice Library -> "Add to my voices", so it shows up
    on /app/voices) works fine on the free tier via the API — confirmed with
    a real synthesis call, a cached repeat (0.32s vs 1.1s, byte-identical
    output), and both frontend pages (visit-site.html, kiosk.html) taking the
    real-audio path rather than the speechSynthesis fallback.
    Documented where the next person hits it: tts.py's own docs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
2026-08-11 Add continuous simulated telemetry to the ESP32 sketch, verified against the real backend
    Typing "reading gas 450" one at a time proves the endpoint works but
    doesn't look like a sensor. New "auto" Serial command instead posts a
    simulated gas ppm and temperature reading every 4 seconds on its own: a
    random walk gently pulled toward a baseline (a real reading drifts, it
    doesn't jump independently frame to frame) with an occasional larger
    random spike, so gas crosses into warning/critical territory on its own
    during a demo instead of only on a typed command.
    Couldn't compile the .ino here (no Arduino toolchain), so verified the
    logic by replicating the exact same drift/spike math in a throwaw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
    [alert_sim.ino]
2026-08-11 Fix ESP32 sim compile error and move credentials out of tracked sketch
    autoMode and the other telemetry-simulation globals were declared after
    printStatus() referenced them; C++ doesn't hoist globals like JS does, so
    this failed to compile. Moved them next to authToken, before any function
    definition.
    While re-reading the file for that fix, found a real WiFi password had
    been typed directly into the tracked .ino. Moved WIFI_SSID, WIFI_PASSWORD,
    API_BASE, DEVICE_EMAIL, and DEVICE_PASSWORD into a gitignored secrets.h
    (committed secrets.h.example as the template), matching this project's
    existing .env pattern, so credentials can't land in git history again.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
    [alert_sim.ino]
2026-08-11 Fix timestamp, input-validation, and unbounded-growth bugs; add reading history
    Timestamps: SQLite drops tzinfo, so isoformat() emitted offset-less strings
    that JS parsed as local time — a reading 3 seconds old displayed as "6h
    ago", and every history/acknowledged-at time was off by the viewer's UTC
    offset. Marked UTC explicitly on the way out (_iso_utc, applied across
    models.py, admin.py, gate.py).
    Sensor values: NaN/Infinity passed float() but serialize as bare NaN/
    Infinity tokens, which no browser's JSON.parse accepts. One such reading
    persisted and /api/alerts/readings returned invalid JSON to every client
    from then on, breaking Live Readings until the row was deleted by hand.
    Any si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
    [alert_sim.ino]
2026-08-11 Add judge Q&A study guide; give the round-one/round-two section real design
    The homepage's report section carried the right content but none of the
    page's own design language — no panels, no elevation, no accent, and the
    scope figures buried in a grey one-line colophon. It read as a markdown
    document on a page that has a panel system sitting unused.
    Now: the round-one/round-two comparison is two contrasted cards, round one
    flat and dashed (the past), round two on paper with real lift and accent
    ticks (built). The eight build areas become findable cards instead of eight
    paragraphs of grey prose. The figures get the big-number treatment they
    earn, corrected to the current 39 endpoints and 8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
2026-08-13 Add real-hardware ESP32 sensor node: MQ-9 gas + DHT11 temp/humidity
    New esp32-main/ppe_sensors/ppe_sensors.ino, kept separate from
    esp32-sim/alert_sim.ino rather than overwriting it — the simulator stays
    as a hardware-free fallback if wiring breaks at the venue, since flashing
    it back still demos the alert pipeline with believable numbers.
    Reads a real MQ-9 through a 10k/10k divider on GPIO0 (halving its ~5V
    swing into the ESP32-C3's ADC range) via analogReadMilliVolts() for the
    chip's own eFuse-calibrated reading, and a real DHT11 on GPIO4, skipping a
    report on the (occasional, expected) failed DHT read rather than posting
    NaN — the backend now rejects non-finite values outright anyway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
    [ppe_sensors.ino]
2026-08-13 Make both ESP32 sketches work against a hosted HTTPS backend
    HTTPClient::begin(url) alone only handles plain HTTP — once the backend
    moves from a LAN IP to a hosted https:// URL, that call fails to connect,
    with no code change to explain why: the ESP32 would go from working to
    silently unable to reach the API.
    beginRequest() picks the transport from the URL's own scheme: plain
    http.begin(url) for "http://", or http.begin(secureClient, url) through a
    shared WiFiClientSecure for "https://". Deploying no longer needs a code
    change — updating secrets.h's API_BASE to the hosted URL is enough, since
    the scheme comes along with it.
    secureClient.setInsecure() skips certificate validation rathe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
    [alert_sim.ino, ppe_sensors.ino]
2026-08-13 Close the guest-auth gate hole; add rate limiting
    Guest sign-in (/api/auth/guest) needs no credentials at all, and
    /api/gate/alerts + /api/gate/sensors only required @jwt_required() — any
    signed-in session, guest included. That meant anyone who could reach the
    API could create a guest session and post a fabricated critical alert,
    holding the gate for everyone with zero authentication. Flagged in an
    earlier security pass and deliberately left open at the time since closing
    it would've broken the ESP32 sketches (which were guest-authenticated);
    now that both sketches support real device credentials, there's no reason
    left to leave it open.
    device_required (gate.py) rejects any guest session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
2026-08-16 Add a role-scoped help chatbot to every authenticated page
    A floating widget (js/chatbot.js), mounted once by Shell.render() so all
    10 pages that use the shared shell get it with zero per-page wiring —
    admin console, history, and the visitor demo page, not the marketing
    homepage or device-mode kiosk/pi-home screens.
    Backend: chatbot.py calls Google Gemini's free tier (aistudio.google.com,
    no card required), same "blank key means not configured, degrade
    gracefully" convention as tts.py/ElevenLabs. The role-scoping is a system
    prompt per account type (guest/operator/admin — the same three tiers the
    sidebar already labels a user with), grounded in the actual page-access
    rules (grepped ever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
2026-08-16 Fix the chatbot's default model and add a retry for transient overload
    Verified the real Gemini key against the API directly: gemini-2.0-flash
    (the original default) is retired server-side and 404s every request.
    Switched to gemini-flash-latest — an alias Google keeps pointed at their
    current recommended fast model, so a future retirement doesn't silently
    break this the same way again.
    Also hit genuine transient 503s from Gemini's free tier during testing —
    three identical back-to-back requests came back 503/200/503, confirming
    it's Google's model reporting itself overloaded, not a bug on our end
    (their own docs say to retry on this). Added one retry after a 1.5s pause
    in chatbot.ask().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
2026-08-16 Render the chatbot's markdown instead of dumping it as raw text
    The assistant's replies use bold and bullet lists, per the system
    prompt's own "a few sentences or a short list" instruction, but the
    widget appended them via textContent — so **bold** showed as literal
    asterisks and list markers as literal dashes/stars, with no actual
    structure. Added a small markdown-lite renderer (bold + bullets only,
    matching what the prompt actually asks the model for) that HTML-escapes
    first and only then reintroduces the handful of tags it builds itself, so
    nothing in the model's output can inject real HTML. Applied only to
    assistant messages — the user's own typed text and the typing/error
    placeholde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
2026-08-16 Redesign the chatbot widget; render italics and numbered steps; retry harder
    Interface: custom inline-SVG icon that cross-fades to a close glyph in the
    same grid cell (so the button never resizes mid-swap), a real header with
    the assistant's name and the viewer's role, a reset button to clear the
    conversation between demos, animated three-dot typing indicator instead of
    a literal "…", tailed message bubbles, panel entry animation, and a send
    button that stays disabled until there's actually something to send.
    Added role-scoped suggestion chips on first open. Someone handed this
    product cold doesn't know what it can answer, and a blank input with a
    cursor is the least helpful thing to show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
2026-08-16 Switch the chatbot to the lite model — the flagship free tier is 20/day
    The repeated "assistant is busy" failures weren't overload at all: the
    error body said 429 RESOURCE_EXHAUSTED, quota id
    GenerateRequestsPerDayPerProjectPerModel-FreeTier, value 20. That is
    twenty requests per DAY, and building/testing this feature spent them.
    My own error handling hid it — I'd lumped 429 in with 503 under one
    "busy right now, ask again in a moment" message, which is not just vague
    but actively wrong for a daily cap: it tells someone to retry a request
    that cannot succeed until tomorrow. Split them, and the 429 message now
    says what actually happened.
    The quota is per-model (it's in the quota id), s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
2026-08-16 Chatbot: persist across navigation, know the current page, fall back to Groq
    Persistence: the conversation was wiped on every page change, which made
    the widget worse the more useful its answer was — its whole job is to say
    "go to the Settings page", and following that advice destroyed the chat
    that gave it. History and open-state now live in sessionStorage, so the
    panel reopens mid-conversation on the next page. Errors are deliberately
    not stored: "the assistant is busy" isn't part of the conversation and
    shouldn't be replayed as context later.
    Page context: the client sends its filename, the server maps it against a
    fixed table (never interpolating client text into the prompt) and tells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
2026-08-18 Add offline groundwork, camera hot-plug and on-screen exit
    The gate ran as a thin client: every check needed the cloud, and a dropped
    connection stopped it entirely. This lands the first piece of running
    without one, plus two fixes found while testing on the Pi.
    Local mirror (no behaviour change yet)
    GET /api/gate/roster returns roster, policy and active alerts in a single
    snapshot. Three separate calls could disagree with each other and produce
    a verdict matching neither. It is device-only: the payload includes
    rfid_tag, which to_worker_dict() withholds, so this is a badge list and a
    guest session (which needs no credentials) must not be able to enumerate
    it. Verified: guest 4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
    [checkpoint.py, local_store.py, ui.py]
2026-08-18 Let the gate boot with no backend, and keep retrying
    main() returned 1 whenever sign-in failed, so a Pi that rebooted during an
    outage came up dead and stayed dead until somebody noticed and restarted it
    by hand. That is the exact situation offline mode exists for: the power
    comes back before the network does.
    sign_in() now reports whether the backend was *reachable*, because the two
    failures need opposite handling and collapsing them into one boolean is
    what caused this:
    unreachable ordinary outage - boot anyway, retry in the background
    reachable but refusing a bad credential, which waiting cannot fix, so
    still fatal and loud. Falling back to guest would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
    [checkpoint.py]
2026-08-18 Keep hazard alerts when the cloud is unreachable
    A missed PPE check costs a rescan. A missed gas alert has no second chance -
    and until now it was the thing most likely to be lost, because the ESP32
    posts hazards straight to the cloud and nothing on site ever heard them. A
    dropped tunnel meant the reading vanished with no record it existed.
    The Pi now keeps its own copy.
    alert_receiver.py A LAN listener speaking the two endpoints the board
    already calls, so the firmware needs no new protocol -
    point API_BASE at the Pi and the same requests work.
    Raw readings are classified against the sensor
    thresholds t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
    [alert_receiver.py, checkpoint.py, local_alerts.py]
2026-08-18 Read the master ESP32 over USB: badges and hazards on one wire
    The hardware plan is sensor nodes talking ESP-NOW to a master board, with
    the master wired to the Pi by USB. That puts two previously separate inputs
    on one serial line - badge scans (an RC522 on the Pi's own SPI header) and
    hazard reports (an HTTP POST) - so this is a BadgeReader that also feeds the
    local alert store. They cannot be split into two objects even if that read
    better: only one process can hold a serial device open.
    Line protocol, verb first, case-insensitive:
    BADGE 0006238412
    ALERT gas critical fumes near the mixer
    READING gas 450 ppm
    Unparseable lines are ignored rather than logged, because an ESP32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
2026-08-18 Accept badge scans over the network too
    The gate had no usable badge input. The RC522 isn't wired yet and the
    keyboard fallback reads stdin, which under nohup is /dev/null - so the
    reader thread hit EOF and exited at startup. The gate looked healthy and
    could not have processed a single scan, which is also why the full path had
    never actually been exercised.
    POST /api/gate/badge {"tag": "..."} puts a tag on the same queue the local
    readers use, so the gate cannot tell which reader a scan came from and does
    not need to. That covers a networked reader, the master board reporting over
    Wi-Fi instead of USB, and testing before any of that hardware exists.
    Behind the same token as the hazard end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
2026-08-18 Pick the camera by name, and prove it streams before using it
    Swapping the webcam for a depth camera broke capture in a way the hot-plug
    code could not recover from, and exposed two faults.
    First, isOpened() is not proof of a working camera. The Angstrong HP60C
    opens fine and then times out on every read, because it only streams once
    its vendor ROS node has configured it. The gate would sit holding a device
    that produces nothing. _open_camera() now reads a frame before accepting a
    device, which is what separates "present" from "working" and lets the loop
    move on to the next candidate.
    Second, a failed open was leaving the device claimed: the gate held
    /dev/video0 while logging "can't open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
    [checkpoint.py]
2026-08-18 Add a fullscreen toggle to the gate display
    The only way off the fullscreen gate was HOLD TO EXIT, which closes it
    entirely. Reaching the desktop underneath - to check something, plug a
    device in - meant killing the gate and starting it again.
    The icon is drawn on a canvas rather than typed. The usual fullscreen
    glyphs (U+26F6, the diagonal arrows) are not in DejaVu Sans, and a missing
    glyph renders as a hollow box, which is worse than no icon. Lines always
    draw. Brackets point outward to go fullscreen and inward to leave it, so it
    shows what will happen rather than what is currently true.
    The arms are deliberately shorter than half the icon's span: at exactly
    half, arms from neighbouring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
    [checkpoint.py, ui.py]
2026-08-18 Add gate master firmware: RC522 badges and ESP-NOW over USB serial
    The board wired to the Pi was running a PWM fan test - the link was fine
    (CP210x, 115200, 166 lines in 10s) but nothing spoke the gate's protocol.
    This is the firmware that does.
    Badges are read from an RC522 on the VSPI defaults (SS 5, SCK 18, MOSI 23,
    MISO 19, RST 22) and printed as BADGE lines. ESP-NOW packets from the sensor
    nodes are forwarded as ALERT/READING on the same wire, so the Pi has one
    input to read rather than several - which it must, since only one process
    can hold a serial port open.
    The badge encoding is the part worth getting right. The Pi's Python reader
    turns a UID into a decimal integer from the first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
2026-08-18 Add a tool to bind a real badge to a worker
    Every rfid_tag in the database came from seed_workers.py, which hardcodes
    three invented values. No card that exists in the physical world matched
    any of them, so the gate could read a badge perfectly and still have
    nothing to compare it against.
    The UID must be typed from what the reader reports - the master prints
    `BADGE <uid>` and unknown scans surface in the Pi's log - not from the
    number printed on the card. Those two are usually different, and only the
    reader's value is the one the lookup will ever see.
    Enrolment refuses a UID already held by someone else rather than moving
    it. A badge that opens the gate for two people is worse than one th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
2026-08-18 Stage the gate master firmware under static/ for download
    A copy of esp32-main/gate_master/gate_master.ino, placed where the web
    app can serve it so the board can be reflashed from the console without
    cloning the repo onto the machine holding the USB cable.
    Nothing references it yet - the route and the link that would offer it
    are not built. Until they are, this is a second copy of a file the repo
    already tracks, and the two are kept in step only by hand. Serving the
    original directly would avoid that; the copy is what exists today.
    [gate_master_v1.ino]
2026-08-18 Drive the TracX-1b's GNSS receiver, and stop guessing at serial ports
    The GPS module this project owns is a Vanix TracX-1b - a Quectel
    EC200U-CN - and SerialGPSReader cannot drive it. That reader waits for a
    NEO-6M to stream NMEA unprompted at 9600. The EC200U says nothing until
    AT+QGPS=1 switches the receiver on, runs at 115200, and answers a
    location request with a single +QGPSLOC line rather than a sentence
    stream. Confirmed on the device: it enumerated with GNSS off (+QGPS: 0),
    took AT+QGPS=1, and now returns 516 - not fixed yet - while it searches.
    Ports are chosen by USB vendor id. The obvious alternative, matching the
    /dev/serial/by-id name, does not work here: the board reports itse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
    [doctor.py, gps_reporter.py]
2026-08-18 Add a site CCTV camera: ESP32-CAM streaming, proxied through the backend
    A second camera watching the site, separate from the gate. The checkpoint
    camera is occupied deciding who gets in, and aiming it at the yard would
    mean choosing between the two jobs.
    Monitoring only - no PPE detection on this feed. The gate's inference is
    per-badge and bounded; a continuously analysed second camera is a
    standing cost on the backend for footage nobody asked to have ruled on.
    The README says so plainly so the omission reads as a decision rather
    than an unfinished edge.
    The camera holds no credentials and never calls the backend - the backend
    reaches it. That direction was chosen for three reasons. Authe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
2026-08-19 Stop secrets.h backups from being trackable
    `**/secrets.h` does not match `secrets.h.bak`, so a backup taken before
    editing one - which is exactly when a backup gets taken - was left
    trackable while carrying the same WiFi password and device account
    credentials as the original. The same gap existed for `.env` and was
    closed earlier today; this is the other half of it.
    Negates `**/secrets.h.example` so the three tracked example files stay
    visible. Verified all three still are.
2026-08-19 Relay the site camera through the Pi, since the camera has no backhaul
    The camera cannot be reached by the server, and that is not a deployment
    accident to be worked around - it is the situation the system is for. A
    node down a shaft or inside a tunnel has a local link to the gateway
    beside it and no route to anything further. Expecting the backend to open
    a connection inward to that camera assumes a network the site does not
    have.
    So the Pi fetches and forwards, which is what it already does for
    everything else on site: the gate master reaches it over USB, the ESP-NOW
    sensor nodes reach the master. This box is the one thing with a backhaul,
    and the camera is now behind it like the rest.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
2026-08-19 Read the camera's settings when the relay starts, not when it imports
    The relay reported "none configured" however SAFETYFIRST_CCTV_URL was
    set. checkpoint.py imports this module before it calls load_dotenv(), so
    reading os.environ at module level saw the environment as it stood before
    .env was parsed - empty. Every setting in that file looked unset.
    The failure is silent, which is what makes it worth a commit message:
    nothing raises, no warning appears, the camera simply never shows up and
    the log line blames the configuration that is in fact correct.
    gps_reporter.py already reads inside open_gps() and was never affected.
    This now matches it: camera_url() and interval() are called from
    op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
    [cctv_relay.py, checkpoint.py]
2026-08-20 Support several site cameras, and both camera sensors
    Two changes that arrived together because the second camera forced both.
    SENSORS. These boards ship with different modules and the difference is
    not cosmetic. The OV2640 has a hardware JPEG encoder; the GC2145 - sold
    as RHYX-M21-45 and M12-45 - has none at all, emitting only RGB565/YUV/
    RAW. The old sketch asked for PIXFORMAT_JPEG unconditionally, so on a
    GC2145 the camera never initialised.
    Rather than two sketches, or a #define nobody remembers to change, the
    firmware now initialises optimistically in JPEG mode and falls back to
    RGB565 with software encoding when the sensor refuses, dropping to QVGA
    because compressing on the CPU is e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
2026-08-20 Keep a camera visible when the gate that relays it is off
    Two gaps the second camera exposed.
    A camera whose only route out is the Pi disappears entirely while the Pi
    reboots. For a gate that is correct - the decision is server-side, so
    there is nothing to show - but for a monitoring feed "the yard is
    invisible because the gate restarted" is just a blind spot, and the Pi
    has gone down several times while this was being built.
    So a camera may now post for itself, proving itself with a shared secret
    rather than a login. Deliberately not a JWT: sign-in plus refresh on an
    ESP32 buys latency and crashes, and the credential would be worth far
    more if pulled off the flash of a board that sits on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
    [cctv_cam.ino, cctv_relay.py]
2026-08-20 Give the sensor node a way to report, and the master a fan to drive
    Two gaps that showed up once all the hardware was on the bench.
    THE MISSING SENDER. gate_master has carried a complete ESP-NOW receiver
    since it was written - SensorPacket, the callback, the ALERT/READING
    forwarding - and nothing has ever sent to it. Both the sensor node and
    the simulator report over HTTP only, so half that mechanism has never
    had a counterpart.
    ppe_sensors can now report through the master instead, behind
    REPORT_VIA_ESPNOW in secrets.h. Off by default, so a working node keeps
    working. This is the arrangement for a node with no network of its own:
    the Pi is the only box with a backhaul, and the sensor sits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
    [gate_master.ino, ppe_sensors.ino, serial_bridge.py]
2026-08-20 Name each sensor node, so two of them stop overwriting each other
    There are two sensor nodes, not one, and they were indistinguishable.
    Both report "gas", "temperature" and "humidity" with the same source
    string, and the backend keeps one live row per kind - SensorReading is
    keyed on kind alone and overwritten on every report. So the console's
    readout showed whichever node spoke last, flickering between two places
    with nothing to say there were two.
    Alerts were never affected: every reading is evaluated against the
    thresholds as it arrives, so a critical value still raised its alert
    even when the snapshot was immediately overwritten by a calm reading
    from the other node. History was intact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
2026-08-21 Bring the README's hardware section up to what is actually built
    It still said the RFID reader and GPS module had never touched real
    hardware, and described the camera board as planned but not owned. All
    three have been wrong for days: two badges are enrolled and opening the
    gate, the TracX-1b returns a 3D fix that reaches the console, and there
    are two cameras running.
    Anyone picking this repo up cold - a judge, a teammate, us in a month -
    was being told the most finished parts of the build did not exist.
    Now lists all five boards and what each does, including the two details
    that are easy to get wrong: the cameras have different sensors and only
    one of them can encode JPEG, and the fan l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
2026-08-21 Give every board a tracked config, so the repo shows all five
    There are two cameras and two sensor nodes, but the repository only ever
    described one of each. Boards that share a sketch differed solely by
    CAM_ID and NODE_ID in secrets.h - which is gitignored, so nothing in git
    recorded that a second camera or a second node existed, what it was
    called, or how it was set. Anyone cloning this saw half the site.
    Each board now has a board_*.h that is tracked, and secrets.h picks one
    with a single #include. Nothing in those files is secret: an id, an
    orientation, a reporting route. secrets.h keeps only the WiFi password
    and the device account, which is all it should ever have held.
    Copying the s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
2026-08-21 Run the model on the Pi's own CPU, with no backend and no accelerator
    The gate has had two ways to get a verdict and neither works offline.
    Backend inference needs a network. The Hailo accelerator was meant to be
    the answer and is blocked on a HEF compiled by DFC 3.34 against a
    HailoRT 4.17 runtime - a version wall no code here can climb.
    ONNX Runtime is the third way, and it was already installed. Measured on
    this Pi: 317ms per frame at 640x640, 3.2 FPS across four cores. That is
    slow for video and entirely adequate here, because the gate infers per
    badge scan rather than continuously and already throttles to one frame
    every 0.5s. A worker does not change their PPE thirty times a second.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
2026-08-21 Add a live viewer for the Pi's own screen
    Shows the camera with detections drawn and the gate's verdict across the
    top, running entirely on this Pi - no backend, no accelerator, no
    network. It is the on-device path made visible: until now the only proof
    it worked was a column of numbers in a terminal.
    Colours carry the meaning rather than decorating it. Green for PPE the
    model can see, red for the NO- classes and for a denial, amber for the
    person themselves. The verdict bar states what is missing rather than
    just refusing, because "DENIED - Hardhat, Safety Vest" tells a worker
    what to go and fetch and "DENIED" does not.
    Auto-exits after ten minutes. A fullscreen window on a gate display w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
    [live_viewer.py]
2026-08-21 Let the gate decide PPE for itself, with the network down
    The verdict has always come from the backend, so the gate could read a
    badge, see a worker, and still not rule on them without a server. That is
    the one gap the AI HAT was meant to close, and it is blocked on a
    HEF/runtime version mismatch no code here can fix.
    Setting SAFETYFIRST_ONNX_MODEL now moves inference onto this Pi. Blank,
    which is the default, keeps sending frames to the API exactly as before.
    rule_locally() is a deliberate copy of backend/detection.py's
    evaluate_access, down to the order of its checks: a hazard outranks PPE
    compliance because someone in full gear is still not safe to admit into a
    gas leak, and an empty do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
    [checkpoint.py]
2026-08-21 Keep the policy, the readings and the camera when the cloud is gone
    Three holes in offline mode, found by asking what the gate still cannot
    do on its own.
    THE POLICY was the serious one. state.required was only ever set from a
    backend response, so a gate that booted with no network ruled against the
    hardcoded default rather than the site's actual policy. An administrator
    who added "Mask" to the requirements would have had it silently ignored,
    and the gate would have admitted someone it was configured to turn away -
    a wrong answer wearing the costume of a right one. local_store has been
    caching that policy all along; it is now read at startup, before the
    first badge, and refreshed on every s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
    [badge_reader.py, cctv_relay.py, checkpoint.py, local_readings.py, serial_bridge.py]
2026-08-21 Stop an unreachable camera from burying the gate's own log
    The relay only prints the first of a run of identical failures, so a
    camera that is off for an hour does not write thousands of lines. It
    never worked: urllib3 puts the connection object's address inside the
    error text, and that address is different on every attempt, so each
    repeat compared unequal and printed.
    Seen on the Pi during an offline run — 45 of 63 log lines were the same
    DNS failure for one camera, and the badge decision they were meant to
    frame was lost among them. That is precisely the harm the guard exists
    to prevent.
    Compare on the message with hex addresses masked; still print the full
    one. A genuinely different f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
    [cctv_relay.py]
2026-08-21 Say why vcgencmd is unusable here, not that it is missing
    The comment claimed vcgencmd is not present on this image. It is:
    /usr/bin/vcgencmd exists. What it cannot do is open /dev/vcio, which is
    root:video 0660 while the gate runs as a user outside that group, so it
    exits 255.
    Same conclusion, sysfs, but for the real reason — the old wording would
    send anyone debugging this down the wrong path, looking for a package
    that is already installed.
    [serial_bridge.py]
2026-08-21 Print the master's real MAC, not six zero bytes
    The boot line exists to hand you the address each sensor node needs for
    MASTER_MAC. On the bench it reported 00:00:00:00:00:00, because
    WiFi.macAddress() answers zeros until the Wi-Fi driver has finished
    starting and setup() prints before it gets there.
    Anyone configuring a node from that line would have pinned it to the
    zero address and waited for packets that could never arrive - which
    matches ESP-NOW never having carried anything between these boards.
    Read from eFuse with esp_read_mac(ESP_MAC_WIFI_STA) instead: available
    immediately, independent of driver state.
2026-08-21 Point both sensor nodes at the master that actually exists
    The ESP-NOW route was written but never usable: MASTER_MAC held the
    placeholder 24:6F:28:AA:BB:CC, and the master's own boot line - the
    documented place to get the real one - printed six zero bytes until
    e2574a4 fixed it.
    With that fixed the master reports 88:57:21:79:C3:C4 on channel 1, so
    set it and turn the route on. Both node files get the same master; they
    differ by NODE_ID, which is what keeps their readings apart.
    [board_gate.h, board_yard.h]
2026-08-21 Let a sensor node report without someone typing at it
    autoMode started false, so a freshly powered node sampled nothing until
    a human opened a serial console and sent "auto" - and forgot again at
    the next power cycle. Confirmed on hardware: the node initialised
    ESP-NOW against the master correctly and sat there sending nothing, and
    the Pi's readings buffer stayed empty at zero rows.
    A node's normal condition is unattended and out of reach. Default it to
    on; the toggle remains for bench work.
    [ppe_sensors.ino]
2026-08-21 Say on the home page what the hardware now actually does
    The roadmap section still described the boards as future work. They are
    not: the badge reader runs on an ESP32 that carries scans to the Pi over
    USB, PPE is decided on the Pi itself with no server in the loop, the
    sensor nodes reach the gate over ESP-NOW without joining any network,
    and the gate keeps ruling with the link fully severed. All of that was
    verified on the bench today, so "Next" was simply wrong.
    Moves those into a second Working-today column, leaves the turnstile
    relay, multi-gate and AI HAT acceleration under Next, and corrects the
    two architecture notes that described the old wiring.
    Counts refreshed against the repo r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
2026-08-22 Tell a sensor node whether the master actually heard it
    The node printed "-> sent" whenever esp_now_send() returned ESP_OK, and
    a comment claimed ESP-NOW offers no acknowledgement the caller can see.
    It does: unicast is acknowledged at the MAC layer and the status arrives
    in a send callback.
    That mattered immediately. A second node was flashed today, printed
    "ESP-NOW yard_gas reading -> sent" every four seconds, and not one of
    those readings reached the Pi - the buffer held 154 gate_gas rows and no
    yard_gas at all. The node reported success for packets nobody received.
    Register the callback and report the real answer. The queue result is
    still printed, but says "queued", which is all it ev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
2026-08-22 Match the send callback to the core's actual signature
    esp_now_send_cb_t in esp32 core 3.3.11 is
    void (*)(const esp_now_send_info_t *, esp_now_send_status_t)
    not the older (const uint8_t *mac, status) form, which failed to compile
    with "no matches converting" at the register call.
    Read out of the core's own esp_now.h rather than assumed.
    [ppe_sensors.ino]
2026-08-22 Include esp_now.h where the generated prototypes can see it
    The send callback failed to build with "'esp_now_send_info_t' does not
    name a type" on a line whose types are plainly in scope by eye. They are
    not in scope after preprocessing: the Arduino builder emits forward
    declarations for this file's functions and places them after the first
    run of includes, which sat above the #ifdef REPORT_VIA_ESPNOW block
    holding esp_now.h. The generated prototype therefore mentioned a type
    nothing had declared yet.
    Hoist both headers to the top include block. They are declarations only
    and cost nothing on the WiFi route.
    [ppe_sensors.ino]
2026-08-22 Discard the serial backlog waiting at the port when we open it
    Starting the gate filed a burst of readings that never happened: 95 rows
    of gate_gas in one second, every one the identical value 222.0, stamped
    with the moment the port opened. Steady state is one clean reading every
    couple of seconds, so only the backlog is wrong.
    It is data the master emitted while no process held the port, so it is
    stale by definition and its arrival time says nothing about when it was
    measured. Drop it rather than record 95 fictional samples and replay
    them to the cloud.
    [serial_bridge.py]
2026-08-22 Turn the camera's radio down so it can finish connecting
    The board boots cleanly, detects its OV2640 and reports ready, then the
    ROM banner appears partway through "[wifi] connecting......" - four
    times in a minute on one capture, with rst:0x10 (RTCWDT_RTC_RESET)
    among the causes.
    Nothing in this sketch restarts the chip, and the connect loop has no
    timeout, so the reset is external: the supply collapsing under the
    radio's transmit spike while the camera is also drawing. An ESP32-CAM
    running off a USB-serial adapter's rail sits right at the edge of that.
    8.5dBm is about a quarter power - enough for a camera a few metres from
    the AP, and enough to stop it resetting before it ever gets an ad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
    [cctv_cam.ino]
2026-08-22 Renew a session the backend has stopped accepting
    signin_retry_loop only started when the gate failed to authenticate at
    boot, and returned the moment it succeeded. So it covered a Pi rebooting
    during an outage and missed the commoner case: a session the backend
    later refuses, after a redeploy or once the seven-day token expires.
    Nothing renewed it.
    Seen for real today. The backend was restarted; from that moment every
    frame the relay posted came back 401 - 254 of them - while the gate
    reported itself healthy and signed in. Badges and readings would have
    been refused the same way. It only recovered when the gate was restarted
    by hand, which is not a thing a site should need to know.
    Two ch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
    [checkpoint.py]
2026-08-22 Warn that a bare camera URL splits one camera into two tiles
    A camera posting for itself files frames under its CAM_ID. A bare URL in
    SAFETYFIRST_CCTV_URL makes the relay derive an id from the hostname
    instead, so "http://safetyfirst-cam.local" becomes "safetyfirst-cam"
    while the camera's own uploads say "cam".
    Hit this the moment the direct-upload fallback was switched on: the
    backend showed 2135 frames under one id and 7 under the other - the same
    camera as two tiles, neither overwriting the other, which is precisely
    the coordination the fallback is designed not to need.
    The camera already prints the correct line at boot. Say so here, next to
    the setting someone is actually editing.
    Co-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
2026-08-22 Push camera frames to the console instead of asking for each one
    The console fetched one picture per request. This file's own note
    explained why it could not stream - an <img src> cannot send an
    Authorization header, and a JWT in a query string ends up in logs - and
    chose polling to keep the token in a header.
    That weighed two options and missed a third. fetch() reads a streaming
    body with headers intact, so the console can be pushed frames over
    multipart/x-mixed-replace and paint them itself, with no token anywhere
    near a URL. Verified in the browser: the tile went from 44 to 58 frames
    in six seconds, keeping pace with the relay, where before every frame
    cost a request, a TLS round trip an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
    [board_cam.h, cctv_cam.ino, checkpoint.py]
2026-08-22 Let the camera change resolution without a reflash
    Frame size was compile-time only, so tuning it meant a full flash cycle
    per experiment - and on a board with no auto-reset that is a jumper, two
    power cycles and a rebuild to answer one question.
    The right frame size is a property of the link rather than of the code.
    Measured on this camera: VGA runs about 28KB a frame at 9.6fps, QVGA
    roughly a quarter of that at about double the rate. Which one is right
    depends on whether you are watching over the LAN or through a tunnel on
    a phone hotspot, and that changes between one demo and the next.
    Espressif's own CameraWebServer exposes the same control for the same
    reason. Range-checked at SVGA be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
    [cctv_cam.ino]
2026-08-22 Read the camera's stream instead of asking it for each picture
    The relay fetched /snapshot on a timer, so twice a second the camera
    accepted a connection, produced a frame, answered and closed. The board
    exists to stream - it has a hardware JPEG encoder precisely so nothing
    needs computing on it - and a request per frame was the one part of that
    job we kept making it repeat.
    Now it holds /stream open and keeps only the newest frame, which the
    sender posts at the configured interval. What reaches the console is
    therefore what the camera saw a moment ago, rather than whatever it
    could be persuaded to produce on demand.
    Two threads, because posting over the gate's uplink takes long enough
    tha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
2026-08-22 Say what the camera interval now means, and stop advising 1.0
    It used to be a fetch-and-post rate, so lowering it queued work the
    relay could not finish: at 0.2s the feed managed 0.35 frames a second,
    slower than it did at 1s. The advice to keep it around 1.0 followed from
    that.
    Reading the camera's stream changed the shape of it. The newest frame is
    always waiting, so this only decides how often one is forwarded, and the
    same link went from 1.77/sec at 0.5s to 3.80/sec at 0.1s with no errors.
    The ceiling is now the uplink rather than the setting.
2026-08-22 Size the buffers for any frame, then run at the configured one
    Frame buffers are allocated once, at init, so a camera that allocated
    for QVGA can never be raised afterwards - which made /control a
    one-way trip and left the range capped at SVGA to avoid wedging a live
    stream.
    Espressif's CameraWebServer solves this by initialising at UXGA and
    immediately calling set_framesize() down "for higher initial frame
    rate". Adopting that order costs PSRAM this board has spare and makes
    the resolution genuinely adjustable while running.
    Both delivery paths carry whatever the sensor is set to, so this applies
    equally to the Pi's relay and to the camera's own uploads to the
    backend. One setting, both r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
    [cctv_cam.ino]
2026-08-22 Do not let a software-JPEG camera be told to grow
    The previous commit raised /control's framesize ceiling to UXGA on the
    grounds that buffers are now allocated for UXGA at boot. That is true
    only of the hardware-JPEG path.
    A sensor with no encoder - the GC2145 on the yard board - is refused at
    init and re-initialises as RGB565 at QVGA, with a buffer sized for QVGA.
    Raising its frame size would have had the sensor write past what was
    reserved. It would also have been pointless: a VGA RGB565 frame is 600KB
    to compress in software, per frame, on one core.
    Cap the ceiling by which path the camera actually came up on, and say so
    in board_yard.h next to the settings someone would otherwise expec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
2026-08-22 Stop silently clamping the camera interval to 0.2s
    The floor guarded a loop that fetched a frame and posted it in series,
    where asking for frames faster than one round trip only queued work that
    could not finish. Reading the camera's stream separated those, so the
    setting now only decides how often the newest frame is forwarded.
    It had become misleading: .env.example advises 0.1 after measuring
    3.80/sec there, and the code quietly made it 0.2. Both numbers were
    honest on their own and the pair was not.
    Lowered rather than removed - the uplink tops out around 3.8/sec anyway,
    so this is a guard against a typo, not a rate limit.
2026-08-22 Ship the gate camera at a resolution the link can actually carry
    VGA measured ~28KB a frame and lagged visibly: at the 3.8 frames a
    second the uplink managed, that is about 106KB/s, which is roughly all a
    phone hotspot through a tunnel will pass.
    QVGA is around a quarter of that, and quality 18 trims it further at a
    cost that does not show on a monitoring tile this size. Start at the low
    end and raise it only if the link proves to have room - /control makes
    that a browser request now rather than a reflash, so there is no reason
    to guess high.
2026-08-22 Put the homepage on the console's stylesheet and cut it to four sections
    The homepage was a separate visual world that happened to resemble the
    rest of the product: 388 lines of its own CSS redefining 13 tokens the
    console already publishes. It looked consistent only for as long as
    nobody changed app.css.
    It now links app.css and carries composition only, so the warm paper,
    the clay accent and the Fraunces/Inter pairing come from one place.
    Trimmed with it: 12 sections to 4, 1,744 words to 325, 48KB to 13KB.
    The headline, the three-beat gate flow and what actually runs survive;
    the round-two narrative, the decisions section, the colophon stats and
    the tinted bands do not. The long version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
2026-08-22 Close four holes found by attacking the notice feature
    Written straight after shipping it, from probing rather than reading.
    Concurrent issue returned a 500 and no notice. References are sequential
    so they can be quoted, which means two officers issuing at the same
    moment compute the same one; three of five concurrent attempts died on
    the unique constraint. Now retried against a fresh reference - six of six
    succeed with six distinct references.
    Rate limits did not bind per caller. The limiter keys on remote_addr and
    nothing applied ProxyFix, so behind the tunnel every recipient shared one
    bucket: twenty-four callers on distinct addresses locked each other out
    at the twenty-first. That matt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
2026-08-22 Send the notice, and keep what happened when we tried
    The gap between "the system made a notice" and "the contractor got one"
    was a person copying a link. Everything downstream — the due date, the
    overdue badge, the chasing — assumed a delivery nobody had recorded.
    Notices with an email address are now sent when issued, and can be resent
    from the console. Every attempt is stored, successful or not, with the
    provider's own words on failure: paraphrasing an SMTP rejection into
    "delivery failed" throws away the part that says how to fix it. Without
    this an address that bounced and a contractor who had not looked yet were
    indistinguishable, and they call for opposite responses.
    Mail is opt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
2026-08-22 Page the notice list instead of rendering every notice ever issued
    The console fetched all of them on every poll and drew them in one
    column. At fifty-nine that column was 9,596 pixels tall beside a 669
    pixel form, which reads as a broken page rather than a long one, and it
    only grows.
    Status is computed, so it cannot be ordered or paged in SQL - that is the
    price of never letting a stored column claim a state that has stopped
    being true. What is expressible is the half that matters: unanswered and
    not withdrawn is exactly "still needs chasing", and it lands on indexed
    columns. So the default view filters to that and pages it, and the finer
    status ordering happens within the page.
    The list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
2026-08-22 Let the notice link row wrap instead of crushing the URL
    The code element used flex: 1, which resolves to a flex-basis of 0%. A
    zero-basis item has a scaled shrink factor of zero, so it absorbed none
    of the pressure and simply collapsed: at a 375px viewport the link fell
    to 42px wide, unreadable, while JSON / Send / Withdraw stayed at full
    size and pressed against the card's right padding. Below a ~261px card
    the row overflowed outright, since the code could not shrink past its
    own padding and the buttons never shrink below min-content.
    Give the code a real basis (14rem) so the line runs out of room before
    anything gets squeezed, wrap the three actions in .nt-acts so they move
    as one block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
2026-08-22 Identify USB devices instead of counting them, and launch from the desktop
    Two things the checkpoint needed to be plug and play.
    Ports were being guessed. serial_bridge.find_port() returned the first
    /dev/ttyUSB*, which is only the gate master when nothing else is
    attached. The Quectel modem presents seven serial interfaces and sorts
    ahead of it, so plugging in GPS handed the gate an AT command port:
    badges stop being read, and nothing logs a reason. Ports are now matched
    on USB vendor id and then asked to identify themselves - the master
    answers ID? with its own name - and remembered by USB serial number, so
    moving a board to another socket finds it again. A claim registry keeps
    the two re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
2026-08-22 Stop the shipped config from pinning GPS off
    Making auto the code default achieved nothing on a real device: every
    .env is copied from .env.example, and that file wrote SAFETYFIRST_GPS=off
    explicitly. An explicit value always beats a default, so a checkpoint with
    the module plugged in and working still reported no location, and the
    console kept showing the manual pin.
    The example now leaves it blank and says plainly that "off" disables
    location even when the hardware is fine.
    Blank needs handling to mean anything. os.environ.get(k, "auto") returns
    "" for a bare "SAFETYFIRST_GPS=" line - the default only applies when the
    variable is absent, and it is not absent, it is empty. That empty stri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
2026-08-22 Make doctor.py read the .env the gate actually runs on
    doctor.py existed to answer "why is the gate not working", but read only
    the ambient environment - checkpoint.py loads .env through python-dotenv
    and the doctor never did. So it diagnosed a configuration nobody runs.
    Concretely, on a checkpoint whose .env says SAFETYFIRST_GPS=off, the
    doctor saw no such variable, fell back to auto, found the modem and
    reported GPS OK - while the gate it was vouching for reported no location
    at all. Same class of error on SAFETYFIRST_API, where it checked
    localhost instead of the configured backend, and on the device
    credentials, which it called missing while they sat in the file.
    A pre-flight check tha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
    [doctor.py]
2026-08-22 Stop the doctor failing on configurations the gate supports
    Two false alarms found by running the pre-flight on the real Pi, both
    exposed by teaching it to read .env.
    SAFETYFIRST_CAMERA accepts a name fragment as well as an index -
    checkpoint.py says so explicitly and resolves it through
    _camera_candidates(), deliberately not int()-ing it "where a name would
    raise at import and take the gate down". doctor.py int()-ed it anyway.
    That was harmless while it ignored .env; now that it reads the same file
    the gate does, a checkpoint configured with SAFETYFIRST_CAMERA='HD
    camera' - which works - crashed the doctor mid-run with a ValueError,
    taking every check after it with it. It now resolves thro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
    [doctor.py]
2026-08-22 Always test the badge reader, not only the SPI one
    check_reader() ran behind `if spi and libs`, so a checkpoint without the
    RC522 libraries skipped it entirely and printed "Skipped - SPI or
    libraries unavailable". But badges do not come from SPI on this project:
    they come from the sensor mesh through the master ESP32 over USB, and
    open_reader() prefers exactly that, falling back to the RC522 only when
    no master is attached.
    The effect was that the badge wire - the one component a gate genuinely
    cannot work without - went untested on every Pi wired the way this
    actually ships, and the report said so in a line that reads like a
    missing dependency rather than an unverified gate.
    It now always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
    [doctor.py]
2026-08-23 Stop the badge probe rebooting the board it is trying to identify
    Opening a CP2102 asserts DTR, which on an ESP32 dev board is the reset
    line. So identifying the gate master rebooted it, and the probe then
    spent its window reading a board that was still coming up. Measured on
    the gate: find_gate_master() returned None on the first call and the
    device on the second, from one process, seconds apart.
    That coin flip is not a retriable inconvenience. open_reader() calls
    find_port() once, and a falsy answer sends it past the serial branch to
    the MFRC522 and then to the keyboard - for the life of the process. The
    running checkpoint showed exactly that: it held ttyUSB1 for GPS and
    video0 for the ca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
    [usb_devices.py]
2026-08-23 Run the gate unbuffered so its log is not minutes behind
    launch.sh redirects stdout to checkpoint.log, and Python block-buffers
    stdout when it is a file rather than a terminal. So the startup lines -
    which reader attached, where inference runs, whether the camera opened -
    sat in an 8KB buffer while the log read empty.
    That defeats the point of the launcher. There is no console behind a
    desktop icon, so the log is the only evidence there is, and it has to be
    there at the moment someone goes looking. Observed on the gate: the app
    was up and healthy with two lines in a log that should have had a dozen.
2026-08-23 Put the single-instance lock in the gate, not in its launcher
    launch.sh held the lock, so it guarded only launches that went through
    launch.sh. The desktop icon, a terminal, a systemd unit and an ssh
    session all start checkpoint.py directly and took no lock at all.
    That is not theoretical. Two gates ran at once on the device: both had
    the camera and the GPS interface open, they fought over the master's
    serial port, and the loser logged "master disconnected" in a loop while
    badge scans went unread. The symptom reads as failing hardware.
    checkpoint.py now claims an exclusive flock for its own lifetime and
    refuses to start if another gate holds it, whichever way either was
    launched. flock is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
    [checkpoint.py]
2026-08-23 Say so when a deploy is missing the settings only hosting needs
    render.yaml set neither TRUSTED_PROXY_HOPS nor PUBLIC_BASE_URL, and both
    are wrong specifically once hosted.
    A managed host terminates TLS at its own load balancer, so every request
    reaches the app from one address. With TRUSTED_PROXY_HOPS at its default
    of 0 the limiter counts the whole internet as a single caller and real
    users 429 each other out - the public notice pages first, since there the
    limiter is the only protection there is. Measured locally: 24 distinct
    addresses shared one bucket. render.yaml now pins it to 1, the true
    number of proxies; higher would be worse than lower, because each extra
    hop is another address a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
2026-08-23 Teach the assistant about the pages it could not name
    The help assistant's knowledge stopped before the last round of work. It
    had never heard of Safety Notices at all - the whole outbound path by
    which a refusal reaches someone without a login - and could not name the
    Site Cameras, Checkpoint display, or Device Home pages either. Asked
    about any of them it would either refuse or invent, and inventing is
    worse: a confident wrong answer about how to send a notice is how one
    gets sent wrong.
    The admin prompt now covers issuing a notice, the capability link that
    needs no account and expires, email versus "Mark sent", the accept or
    dispute reply and why a dispute must give a reason, the six sta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
2026-08-23 Stop reading the MAC before the radio exists - it boot-looped the master
    printIdentity() was called first thing in setup() and called
    esp_read_mac(ESP_MAC_WIFI_STA) to do it. Flashed to the real board, that
    put the master into a boot loop: the bootloader reached "entry
    0x400805b4" and reset, over and over, emitting nothing but noise. No
    badges, no sensor relay - the gate lost its reader entirely.
    The placement was mine and the reasoning behind it was wrong. An earlier
    commit had established that esp_read_mac beats WiFi.macAddress() because
    eFuse can be read before the driver is up. That is true of the eFuse, but
    it does not make the call safe at the very top of setup() on core 3.3.x,
    before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
    [gate_master.ino]
2026-08-23 Keep deciding on-device when the backend cannot be reached
    Inference was either/or: set SAFETYFIRST_ONNX_MODEL and the gate ruled
    locally and never called the backend, leave it blank and the backend
    ruled and a dropped link meant the gate stopped deciding entirely -
    "Lost contact with the detection service" and nothing else.
    That is backwards for where this runs. A construction site is where the
    connection is worst and the checkpoint matters most, and the demo path
    is a quick tunnel off a laptop. The model was already sitting on the Pi
    with its runtime installed; it just was not allowed to help.
    SAFETYFIRST_INFERENCE=auto (the new default) makes the local model a
    standby rather than a repl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
2026-08-23 Answer from a built-in guide when no model is configured
    The help widget replied "The help assistant is not configured on this
    server" to everything. Accurate and useless: it reads as a broken feature
    rather than an unset key, and it is the first thing anyone poking around
    the console tries - so the assistant's only impression was that it does
    not work.
    Most of what people ask it is "where is X", and this file already knows
    the answer without a model. A keyword-matched guide now covers cameras,
    alerts and thresholds, policy, notices, reports, analytics, personnel,
    the change log, location, captures, and a worker's own records, with a
    directory as the fallback that names the page the person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
2026-08-23 Let the launcher find the screen instead of being told
    Tapping the desktop icon inherits DISPLAY and XAUTHORITY from the session,
    so that path always worked. Every other way of starting the gate inherits
    neither, and tkinter then fails with "couldn't connect to display" however
    healthy the rest of the system is.
    That is exactly what was on the device: a systemd user unit that hardcoded
    DISPLAY=:0, set no XAUTHORITY, could not open the display, and with
    Restart=always retried forever - the icon called it, nothing appeared, and
    the service sat in activating burning CPU.
    XAUTHORITY cannot simply be added to such a unit either. Under Wayland the
    Xwayland cookie is /run/user/<uid>/.mutter-Xwayl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
2026-08-23 Let the gate notice the backend coming back without a badge scan
    state.connected was only ever set true by a successful frame POST, which
    happens exclusively while somebody is standing at the gate being checked.
    So any blip left the display reading offline until the next completed
    check - potentially the rest of a shift - while the roster sync succeeded
    every single minute and printed "[sync] cached 2 workers" to prove it.
    Observed on the device: the Pi could curl the backend in 0.57s and the
    screen still said the service was down.
    The sync loop is the only thing that talks to the backend on a timer
    rather than on demand, so it is the one that can see the link return. It
    now reports what it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
2026-08-23 Describe what the project became
    The README still described the system as it was before safety notices,
    USB device identification, the on-device inference fallback and the
    desktop launcher existed. Someone picking it up cold would have found a
    map missing the last day of work.
    Also records the two deployment settings that fail quietly rather than
    loudly: ADMIN_EMAILS, without which a deployed site has no administrator
    and no way to appoint one, and TRUSTED_PROXY_HOPS, without which the
    rate limiter counts every caller behind a managed host's load balancer
    as the same one.
2026-08-24 Write the README judges will actually be graded against
    Adds a For judges section up top with the demo video, the live site link,
    and dedicated demo credentials for the admin and operator roles (freshly
    created accounts, not anyone's real password), plus a table mapping the
    stated judging parameters (task implementation, complexity, execution,
    innovation, functionality/reliability, documentation, and hardware build
    quality specifically) to where the evidence for each one already lives in
    this file - including an honest, direct answer on PCB/build quality rather
    than a dodge: this is dev boards on point-to-point wiring, not a custom
    carrier board, and the engineering went into the system desi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
2026-08-24 Explain the UPS HAT's job: power loss and network loss are one failure
    The UPS HAT was previously filed under "not yet exercised" with no
    explanation of what it's for, next to a fully-built offline story
    (local cache, on-device inference, retry queue) that never mentioned
    power at all - as if a dead network and a dead mains circuit were
    unrelated problems, when on a real site they're usually the same event:
    the router shares the circuit that just went down.
    Rewrites the hardware entry to say plainly why it's on this build:
    none of the gate's electronics carry a battery of their own, so a power
    cut doesn't degrade anything, it just stops it mid-frame, mid-write.
    Cross-links Running with no i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
2026-08-24 Close four real gaps: CCTV .local resolution, camera failover, homepage, overlay
    Audited the whole document against everything actually built and tested
    this round rather than assuming it was complete, and found four things
    never mentioned anywhere:
    - The two ESP32-CAMs' .local hostnames not resolving from the Pi is a
    real, observed, currently-unresolved issue (the relay logs "Failed to
    resolve 'safetyfirst-cam.local'") that nothing in this document named -
    a judge hitting a blank camera tile mid-demo deserved to find this in
    the README before finding it live. Named plainly, with the working
    fix (SAFETYFIRST_CCTV_URL accepts a plain IP already).
    - CCTV_UPLOAD_TOKEN existed only as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
2026-08-31 Add Reticle as a dev-only verification layer, scoped to frontend/ only
    Wires https://reticle.sh into local development so a browser session can
    be driven and inspected (DOM, network, console, routes) instead of
    guessing whether a frontend change actually works from reading a diff.
    Deliberately narrow. This frontend is vanilla HTML/CSS/JS with no build
    step by design (see the README's Tech stack section), and stays that way
    in production: backend/app.py and the Dockerfile still serve these files
    directly, unbuilt, exactly as before. Vite exists here purely as a local
    dev server for Reticle to attach to - `npm run verify` inside frontend/,
    nothing else changed, nothing in the deploy path touc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
